ahlam26824/ROBOZAPIUBOT/firmware/SoundData.h

#pragma once
#include <Arduino.h>
#include <stdint.h>

// Real recorded/generated sound clips, converted to 8-bit unsigned mono
// PCM at 8000Hz and embedded as PROGMEM byte arrays for
// Sound::playSample() to play back. Source: user-provided WAV files
// (originally 16-bit stereo 48kHz), converted with:
//   ffmpeg -i <name>.wav -ac 1 -ar 8000 -acodec pcm_u8 -f u8 <name>.raw
//
// To replace any of these with a new recording later: run the same
// ffmpeg command on the new WAV, then regenerate the array below with
// `xxd -i <name>.raw` and swap it in -- nothing else in the project
// needs to change.

// ---- ALARM (8000 bytes, 1.0s @ 8000Hz)
const uint8_t ALARM_SOUND[] PROGMEM = {
  0x30, 0x98, 0xb6, 0x1b, 0x94, 0xa2, 0x58, 0x82, 0x89, 0xb0, 0x5b, 0x56,
  0xb0, 0x9f, 0x55, 0x86, 0xab, 0x92, 0x55, 0xa9, 0xaa, 0x18, 0xa9, 0x92,
  0x47, 0x9c, 0x90, 0x9a, 0x65, 0x63, 0xa8, 0x8f, 0x40, 0x88, 0xa2, 0x84,
  0x60, 0x9a, 0xb1, 0x2a, 0x8b, 0x95, 0x60, 0x81, 0x8f, 0x9f, 0x67, 0x5d,
  0x9d, 0x9c, 0x49, 0x72, 0xa7, 0x96, 0x47, 0x95, 0xba, 0x29, 0x84, 0xa8,
  0x5b, 0x79, 0x96, 0xa9, 0x6b, 0x43, 0xaa, 0xb1, 0x29, 0x7b, 0xbe, 0x84,
  0x45, 0x9e, 0xbc, 0x29, 0x82, 0xb3, 0x5d, 0x66, 0xaf, 0xad, 0x45, 0x51,
  0xbb, 0xa3, 0x27, 0x7b, 0xcd, 0x78, 0x47, 0xb5, 0x99, 0x2b, 0x9a, 0x9b,
  0x51, 0x6c, 0xc3, 0x9f, 0x34, 0x71, 0xbd, 0x88, 0x29, 0x91, 0xb8, 0x74,
  0x4f, 0xc1, 0x7e, 0x2f, 0xbf, 0x80, 0x48, 0x88, 0xc4, 0x7e, 0x3a, 0x7d,
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
  0x92, 0x71, 0x81, 0x7d, 0x72, 0x93, 0x80, 0x7b, 0x80, 0x62, 0x84, 0x92,
  0x6d, 0x80, 0x7c, 0x7b, 0x91, 0x76, 0x80, 0x7f, 0x63, 0x8a, 0x87, 0x70,
  0x86, 0x75, 0x7f, 0x8c, 0x76, 0x88, 0x73, 0x68, 0x91, 0x80, 0x77, 0x80,
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
};
const unsigned int SCARED_SOUND_LEN = 30000;
