ahlam26824/ROBOZAPIUBOT/firmware/BLEComm.cpp

#include <Arduino.h>
#include <BLEDevice.h>
#include <BLEServer.h>
#include <BLEUtils.h>
#include "BLEComm.h"

namespace {
  const char* DEVICE_NAME = "Pisu Bot";

  const char* SERVICE_UUID     = "a1b2c3d4-0001-4000-8000-00805f9b0001";
  const char* TIME_CHAR_UUID   = "a1b2c3d4-0001-4000-8000-00805f9b0002";
  const char* TEMP_CHAR_UUID   = "a1b2c3d4-0001-4000-8000-00805f9b0003";
  const char* NOTIFY_CHAR_UUID  = "a1b2c3d4-0001-4000-8000-00805f9b0004";
  const char* MODE_CHAR_UUID    = "a1b2c3d4-0001-4000-8000-00805f9b0005";
  const char* RESULT_CHAR_UUID  = "a1b2c3d4-0001-4000-8000-00805f9b0006";
  const char* FOCUS_CHAR_UUID   = "a1b2c3d4-0001-4000-8000-00805f9b0007";
  const char* DRAW_CHAR_UUID    = "a1b2c3d4-0001-4000-8000-00805f9b0008";
  const char* TEXT_CHAR_UUID    = "a1b2c3d4-0001-4000-8000-00805f9b0009";

  BLEServer* server = nullptr;
  BLECharacteristic* timeChar = nullptr;
  BLECharacteristic* tempChar = nullptr;
  BLECharacteristic* notifyChar = nullptr;
  BLECharacteristic* modeChar = nullptr;
  BLECharacteristic* resultChar = nullptr;
  BLECharacteristic* focusChar = nullptr;
  BLECharacteristic* drawChar = nullptr;
  BLECharacteristic* textChar = nullptr;

  bool connected = false;
  bool pairing = false;

  bool newTimeFlag = false;
  String latestTime = "--:--";
  String latestDate = "";

  bool newTempFlag = false;
  float latestTemp = 0;

  bool newNotifFlag = false;
  String notifTitle = "";
  String notifMessage = "";

  bool newModeFlag = false;
  bool watchModeRequested = false;

  bool newFocusFlag = false;
  String latestFocusCommand = "";

  bool newGameResultFlag = false;
  String lastGameResult = "";

  bool newDrawFlag = false;
  String latestDrawCommand = "";

  bool newTextFlag = false;
  String latestTextCommand = "";

  void splitOnPipe(const String& s, String& left, String& right) {
    int idx = s.indexOf('|');
    if (idx < 0) {
      left = s;
      right = "";
    } else {
      left = s.substring(0, idx);
      right = s.substring(idx + 1);
    }
  }

  class ServerCallbacks : public BLEServerCallbacks {
    void onConnect(BLEServer* s) override {
      connected = true;
      pairing = false;
      Serial.println("BLE: phone connected");
    }
    void onDisconnect(BLEServer* s) override {
      connected = false;
      newModeFlag = true;
      watchModeRequested = false;
      Serial.println("BLE: phone disconnected");
      s->getAdvertising()->start();
    }
  };

  class TimeCallbacks : public BLECharacteristicCallbacks {
    void onWrite(BLECharacteristic* c) override {
      String value = c->getValue();
      splitOnPipe(value, latestTime, latestDate);
      newTimeFlag = true;
    }
  };

  class TempCallbacks : public BLECharacteristicCallbacks {
    void onWrite(BLECharacteristic* c) override {
      String value = c->getValue();
      latestTemp = value.toFloat();
      newTempFlag = true;
    }
  };

  class NotifyCallbacks : public BLECharacteristicCallbacks {
    void onWrite(BLECharacteristic* c) override {
      String value = c->getValue();
      splitOnPipe(value, notifTitle, notifMessage);
      newNotifFlag = true;
    }
  };

  class ModeCallbacks : public BLECharacteristicCallbacks {
    void onWrite(BLECharacteristic* c) override {
      String value = c->getValue();
      watchModeRequested = (value == "1");
      newModeFlag = true;
    }
  };

  class ResultCallbacks : public BLECharacteristicCallbacks {
    void onWrite(BLECharacteristic* c) override {
      lastGameResult = c->getValue();
      newGameResultFlag = true;
    }
  };

  class FocusCallbacks : public BLECharacteristicCallbacks {
    void onWrite(BLECharacteristic* c) override {
      latestFocusCommand = c->getValue();
      newFocusFlag = true;
    }
  };

  class DrawCallbacks : public BLECharacteristicCallbacks {
    void onWrite(BLECharacteristic* c) override {
      latestDrawCommand = c->getValue();
      newDrawFlag = true;
    }
  };

  class TextCallbacks : public BLECharacteristicCallbacks {
    void onWrite(BLECharacteristic* c) override {
      latestTextCommand = c->getValue();
      newTextFlag = true;
    }
  };

  ServerCallbacks serverCallbacks;
  TimeCallbacks timeCallbacks;
  TempCallbacks tempCallbacks;
  NotifyCallbacks notifyCallbacks;
  ModeCallbacks modeCallbacks;
  ResultCallbacks resultCallbacks;
  FocusCallbacks focusCallbacks;
  DrawCallbacks drawCallbacks;
  TextCallbacks textCallbacks;
}

namespace BLEComm {

  void begin() {
    BLEDevice::init(DEVICE_NAME);
    BLEDevice::setMTU(247);

    server = BLEDevice::createServer();
    server->setCallbacks(&serverCallbacks);

    BLEService* service = server->createService(SERVICE_UUID);

    timeChar = service->createCharacteristic(TIME_CHAR_UUID, BLECharacteristic::PROPERTY_WRITE);
    timeChar->setCallbacks(&timeCallbacks);

    tempChar = service->createCharacteristic(TEMP_CHAR_UUID, BLECharacteristic::PROPERTY_WRITE);
    tempChar->setCallbacks(&tempCallbacks);

    notifyChar = service->createCharacteristic(NOTIFY_CHAR_UUID, BLECharacteristic::PROPERTY_WRITE);
    notifyChar->setCallbacks(&notifyCallbacks);

    modeChar = service->createCharacteristic(MODE_CHAR_UUID, BLECharacteristic::PROPERTY_WRITE);
    modeChar->setCallbacks(&modeCallbacks);

    resultChar = service->createCharacteristic(RESULT_CHAR_UUID, BLECharacteristic::PROPERTY_WRITE);
    resultChar->setCallbacks(&resultCallbacks);

    focusChar = service->createCharacteristic(FOCUS_CHAR_UUID, BLECharacteristic::PROPERTY_WRITE);
    focusChar->setCallbacks(&focusCallbacks);

    drawChar = service->createCharacteristic(DRAW_CHAR_UUID, BLECharacteristic::PROPERTY_WRITE);
    drawChar->setCallbacks(&drawCallbacks);

    textChar = service->createCharacteristic(TEXT_CHAR_UUID, BLECharacteristic::PROPERTY_WRITE);
    textChar->setCallbacks(&textCallbacks);

    service->start();

    BLEAdvertising* advertising = BLEDevice::getAdvertising();
    advertising->addServiceUUID(SERVICE_UUID);
    advertising->setScanResponse(true);

    Serial.println("BLE: ready with Draw & Text Animation support");
  }

  void startPairing() {
    pairing = true;
    BLEDevice::getAdvertising()->start();
  }

  void stopPairing() {
    pairing = false;
    BLEDevice::getAdvertising()->stop();
  }

  bool isPairing() { return pairing && !connected; }
  bool isConnected() { return connected; }

  bool hasNewTime() {
    if (newTimeFlag) { newTimeFlag = false; return true; }
    return false;
  }
  String getTime() { return latestTime; }
  String getDate() { return latestDate; }

  bool hasNewTemperature() {
    if (newTempFlag) { newTempFlag = false; return true; }
    return false;
  }
  float getTemperature() { return latestTemp; }

  bool hasNewNotification() {
    if (newNotifFlag) { newNotifFlag = false; return true; }
    return false;
  }
  String getNotificationTitle() { return notifTitle; }
  String getNotificationMessage() { return notifMessage; }

  bool hasNewMode() {
    if (newModeFlag) { newModeFlag = false; return true; }
    return false;
  }
  bool wantsWatchMode() { return watchModeRequested; }

  bool hasNewFocusCommand() {
    if (newFocusFlag) { newFocusFlag = false; return true; }
    return false;
  }
  String getFocusCommand() { return latestFocusCommand; }

  bool hasNewGameResult() {
    if (newGameResultFlag) { newGameResultFlag = false; return true; }
    return false;
  }
  String getGameResult() { return lastGameResult; }

  bool hasNewDrawCommand() {
    if (newDrawFlag) { newDrawFlag = false; return true; }
    return false;
  }
  String getDrawCommand() { return latestDrawCommand; }

  bool hasNewTextCommand() {
    if (newTextFlag) { newTextFlag = false; return true; }
    return false;
  }
  String getTextCommand() { return latestTextCommand; }

}
