ahlam26824/ROBOZAPIUBOT/(commit log)

2026-09-25 Redesign Pisu Bot PC controller UI to match mobile Flutter app editorial theme
    [pisu_bot_pc.py]
2026-09-25 Add Focus Mode (7s touch = 26min timer), custom timer, Stopwatch - firmware, app, and PC software
2026-09-25 Update README: add full wiring diagram, Focus Mode, Stopwatch, PC software docs
